SIFAT19/Implementation-of-a-Low-Cost-ESP32-Based-Single-Channel-EEG/Project Report.pdf

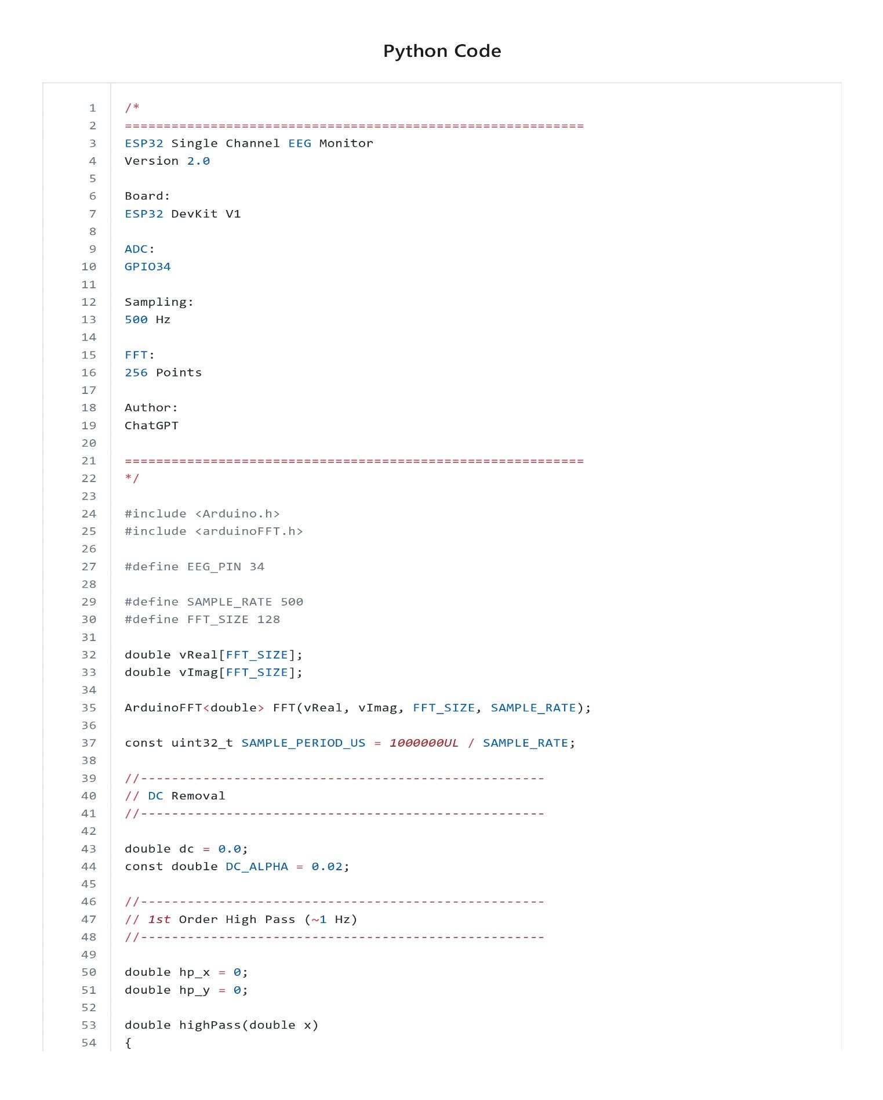
[picture p7: page 17]
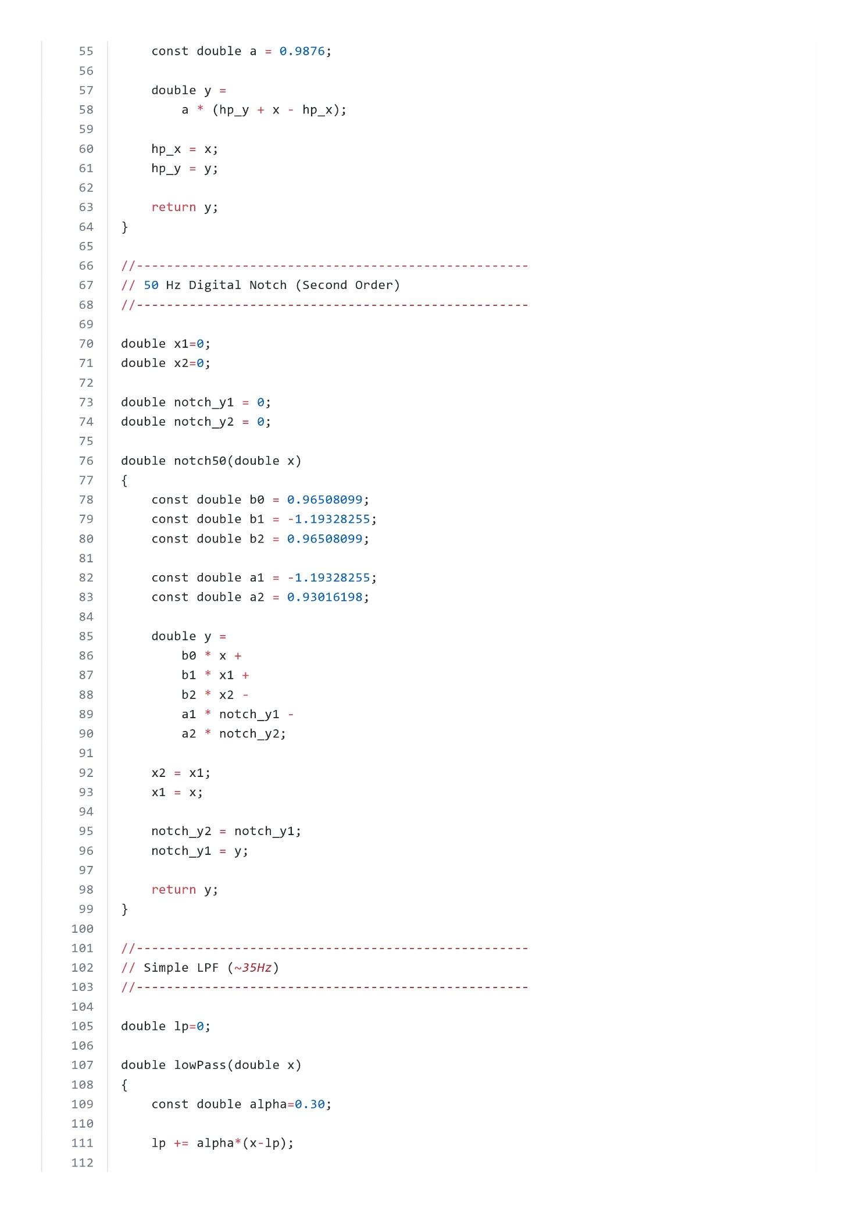
[picture p8: page 18]
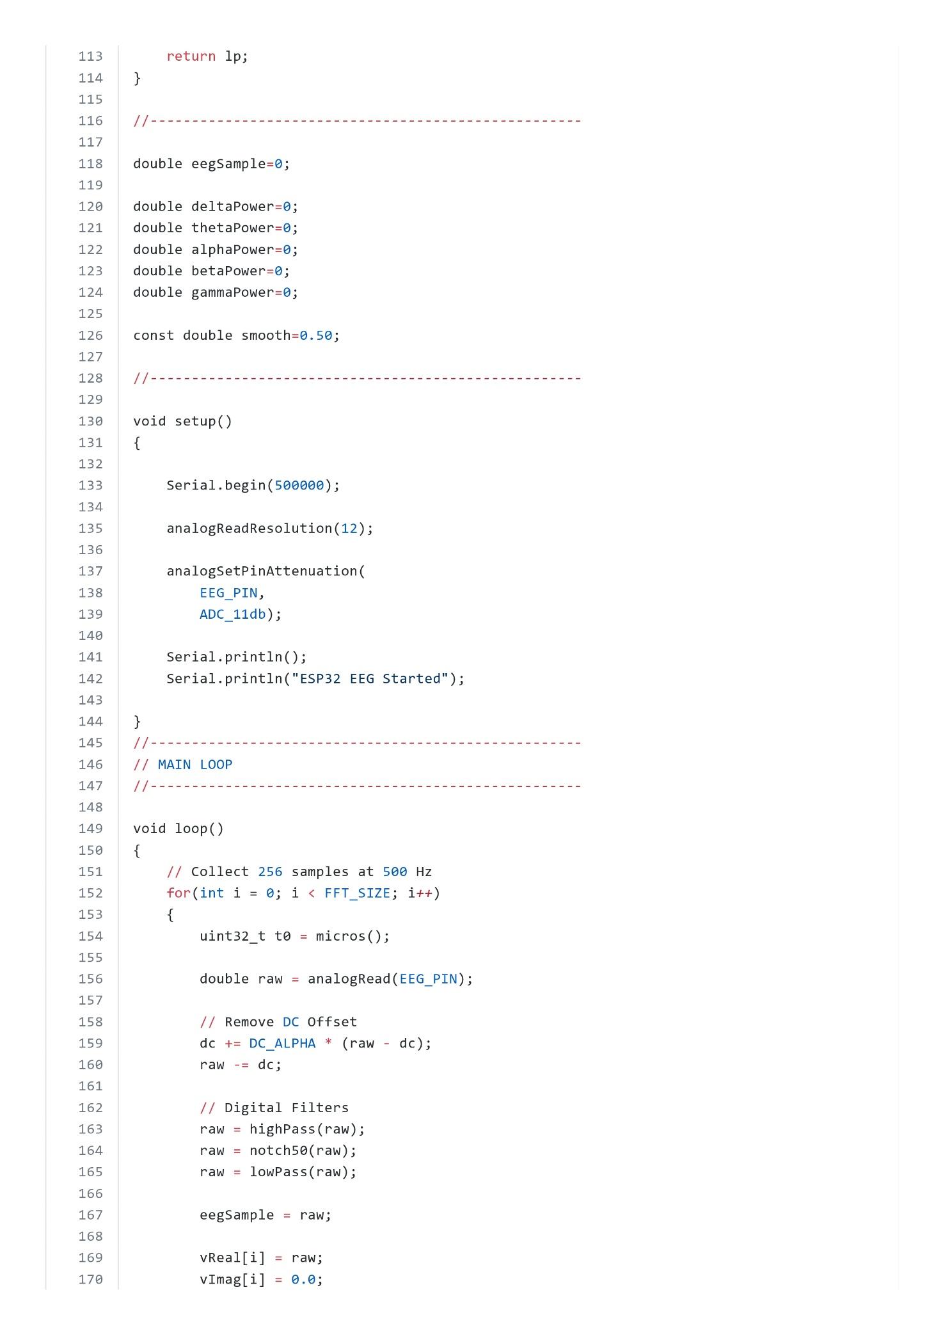
[picture p9: page 19]
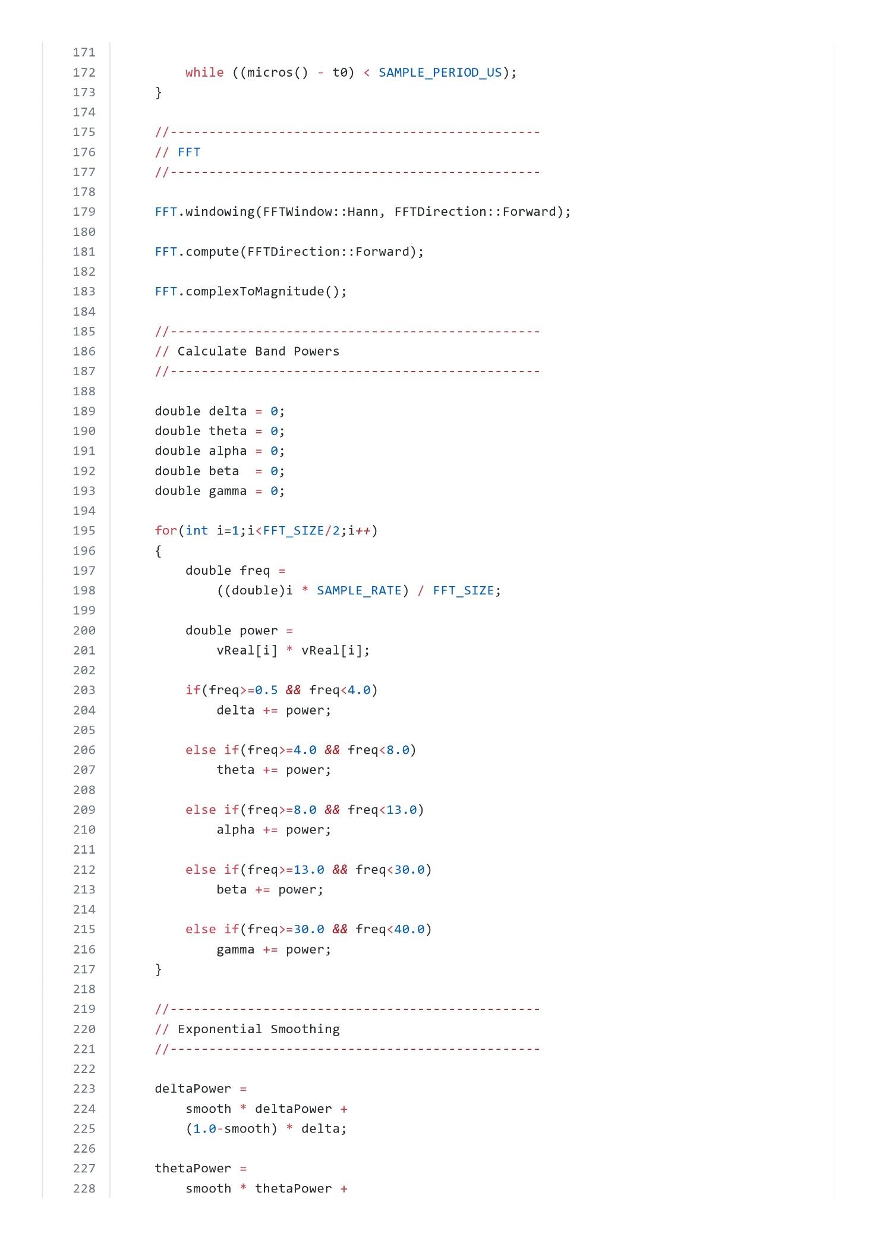
[picture p10: page 20]
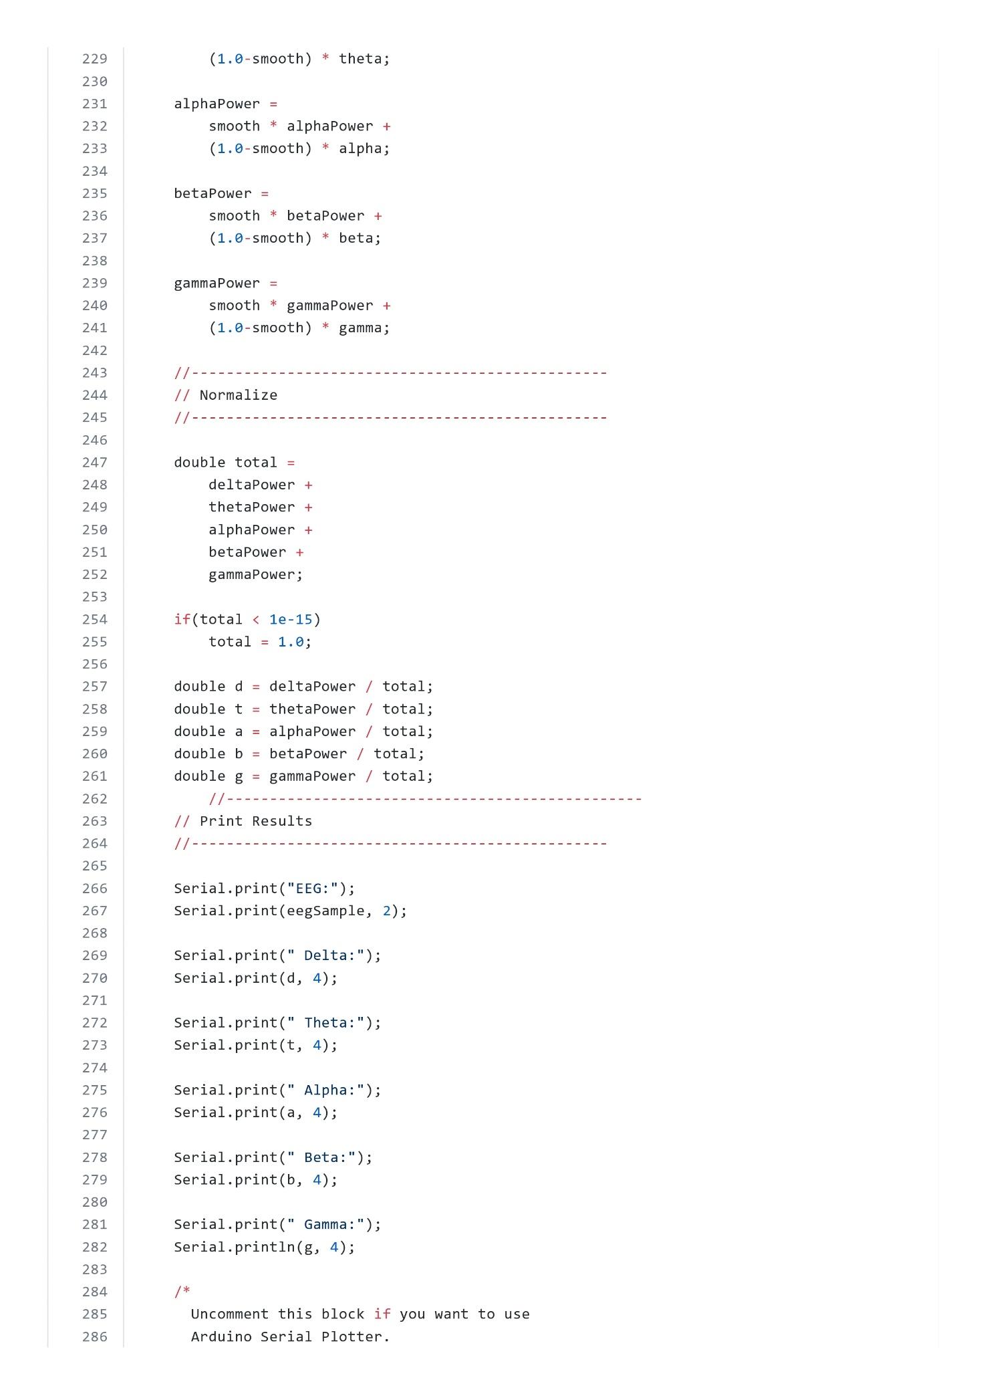
[picture p11: page 21]
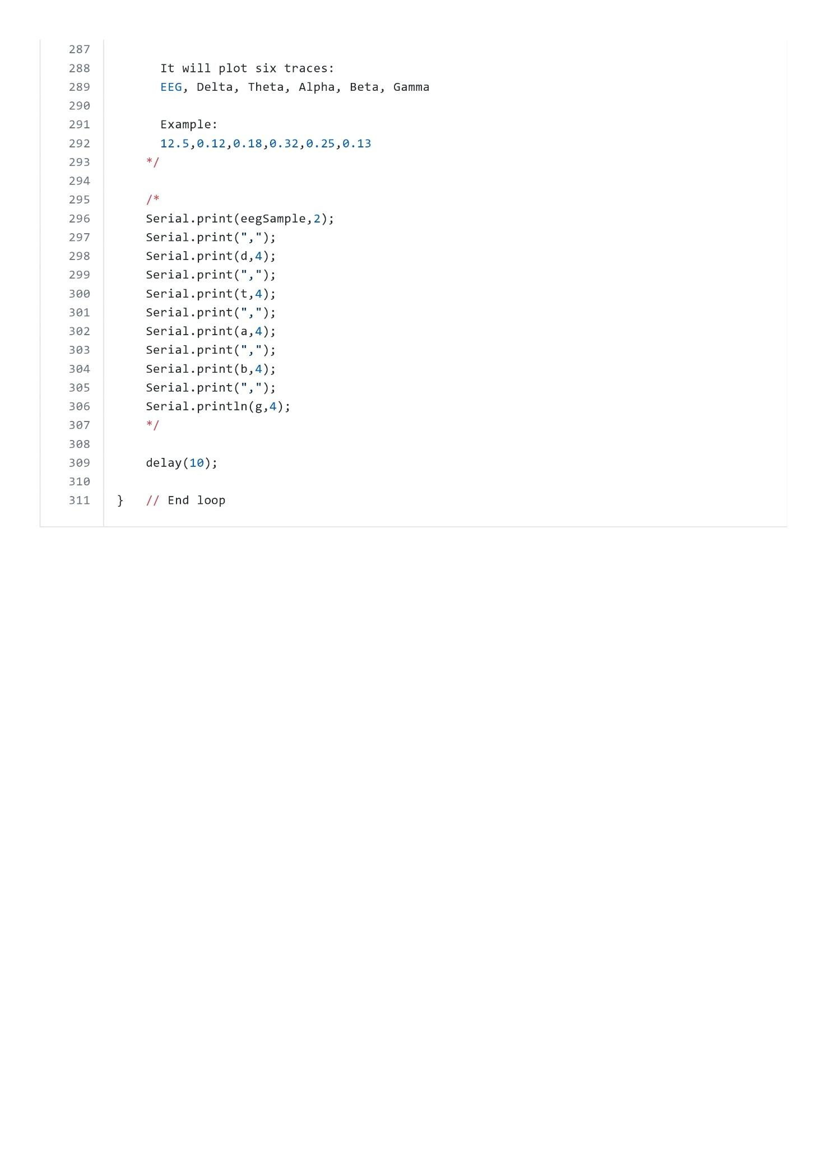
[picture p12: page 22]
